seisyuu-hantatsushi/pcb/ledboard/ledboard.kicad_pcb

## KiCad design ledboard/ledboard.kicad_pcb (2026-04-18)

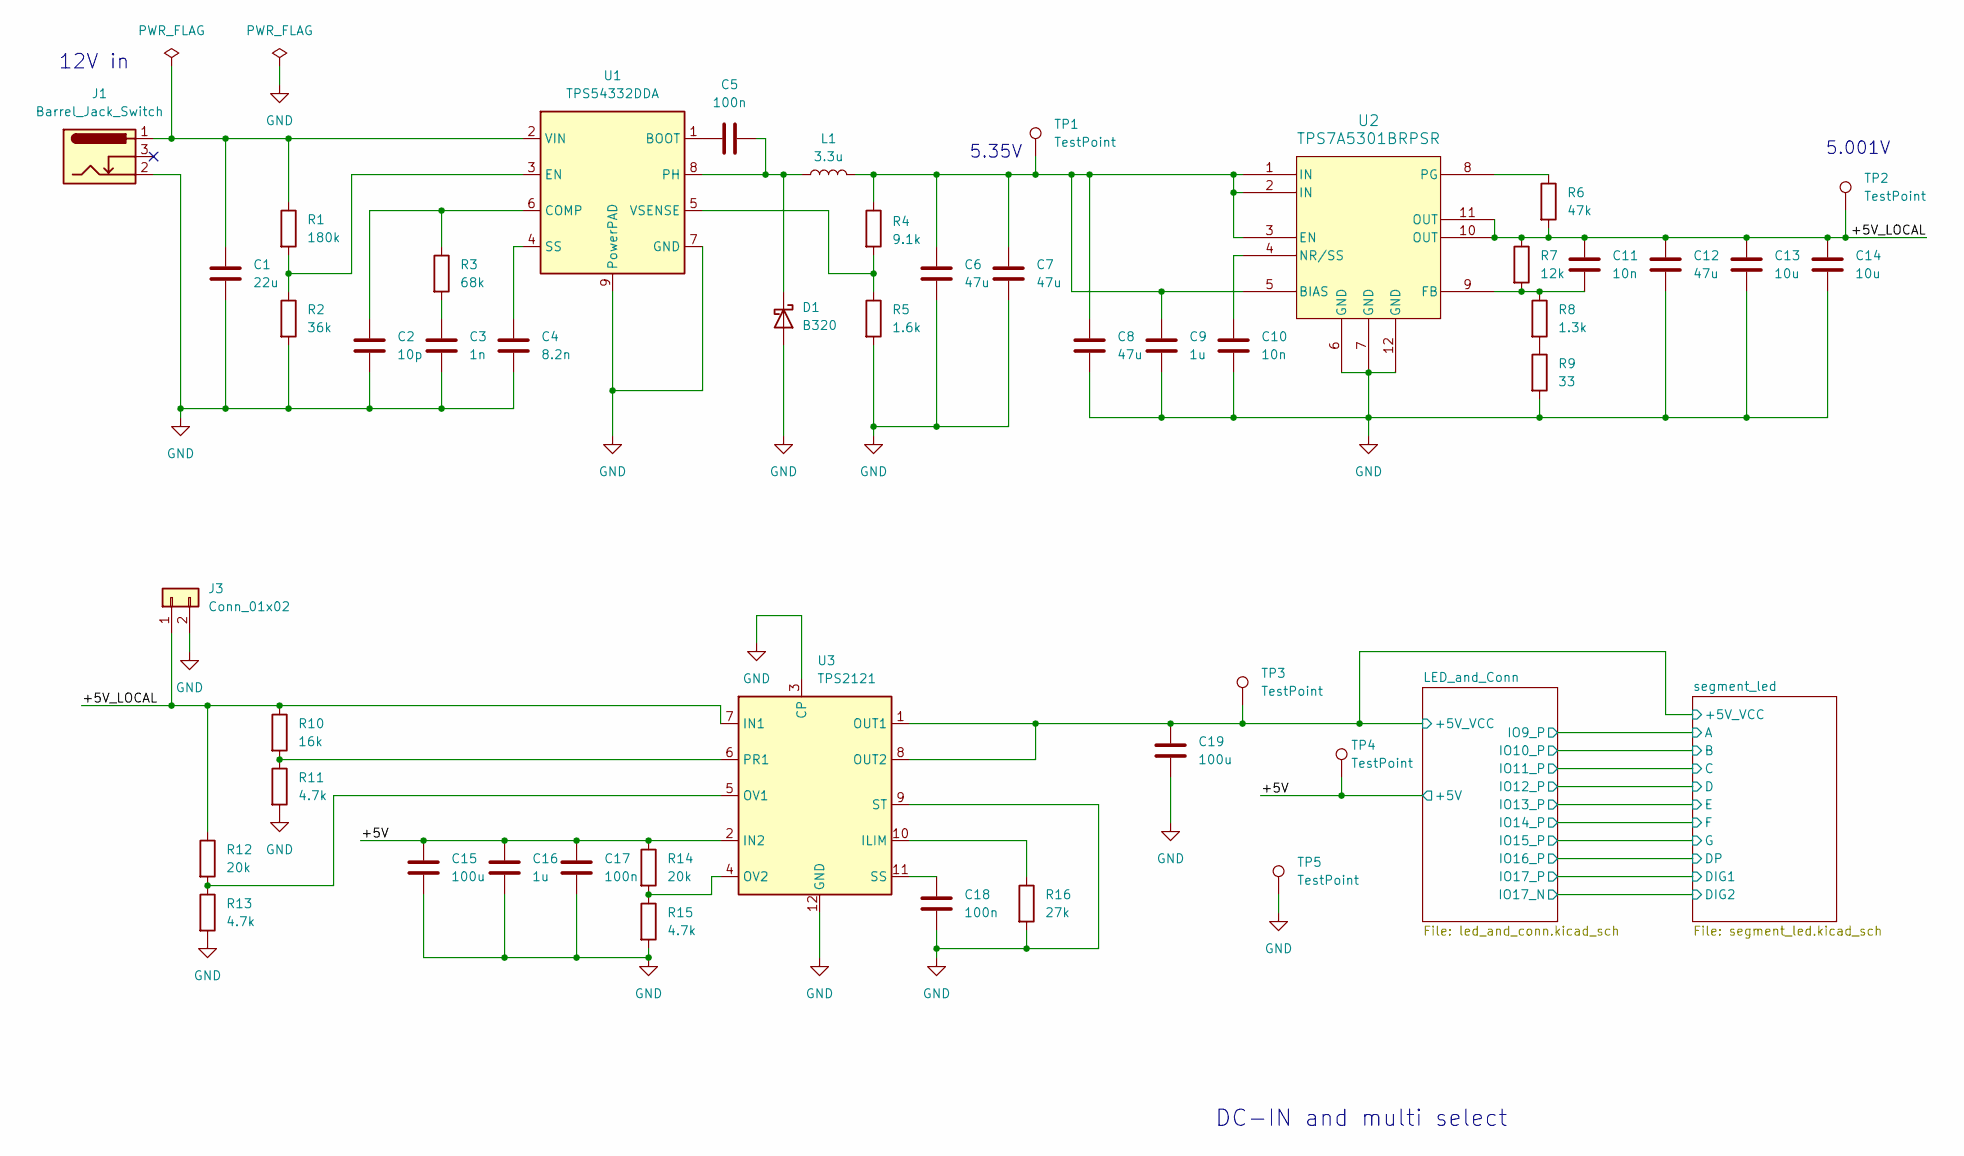
[picture p1: schematic ledboard.kicad_sch]

Parts:
C1: 22u; C_1206_3216Metric; MPN GRM31CC71E226ME15; LCSC Part # C5272872
C2: 10p; C_0402_1005Metric; MPN GRM1555C1E100JA01D; LCSC Part # C161512
C3: 1n; C_0201_0603Metric; MPN GRM033R71C102KA01; LCSC Part # C76942
C4: 8.2n; C_0201_0603Metric; MPN GRM033R61E822KA12D; LCSC Part # C710826
C5, C17, C18: 100n; C_0201_0603Metric; MPN GRM033C81E104ME14; LCSC Part # C412246
C6, C7, C8, C12: 47u; C_1206_3216Metric; MPN GRM31CR61C476ME44; LCSC Part # C385047
C9, C16: 1u; C_0402_1005Metric; MPN GRM155C81A105KA12D; LCSC Part # C162161
C10, C11: 10n; C_0402_1005Metric; MPN GRM155R71C103KA01D; LCSC Part # C85735
C13, C14: 10u; C_0603_1608Metric; MPN GRM188C81C106MA73D; LCSC Part # C182375
C15, C19: 100u; C_1210_3225Metric; MPN GRM32ER61A107ME20; LCSC Part # C84455
D1: B320; D_SMC; MPN B320-13-F; LCSC Part # C134448
J1: Barrel_Jack_Switch; MPD_EJ503A; MPN EJ503A; LCSC Part # C3095117
J3: Conn_01x02; PinHeader_1x02_P2.54mm_Vertical
L1: 3.3u; IND_BOURNS_SRN8040; MPN SRN8040-3R3Y; LCSC Part # C780188
R1: 180k; R_0603_1608Metric; MPN RC0603FR-07180KL; LCSC Part # C123419
R2: 36k; R_0603_1608Metric; MPN RC0603FR-0736KL; LCSC Part # C114619
R3: 68k; R_0603_1608Metric; MPN RC0603FR-0768KL; LCSC Part # C114633
R4: 9.1k; R_0603_1608Metric; MPN RC0603FR-0769K1L; LCSC Part # C114639
R5: 1.6k; R_0603_1608Metric; MPN RC0603FR-071K6L; LCSC Part # C165489
R6: 47k; R_0603_1608Metric; MPN RC0603FR-0747KL; LCSC Part # C105579
R7: 12k; R_0603_1608Metric; MPN RC0603FR-0712KL; LCSC Part # C114659
R8: 1.3k; R_0603_1608Metric; MPN RC0603FR-071K3L; LCSC Part # C125319
R9: 33; R_0603_1608Metric; MPN RC0603FR-0733RL; LCSC Part # C108661
R10: 16k; R_0603_1608Metric; MPN RC0603FR-0716KL; LCSC Part # C137788
R11, R13, R15: 4.7k; R_0603_1608Metric; MPN RC0603FR-074K7L; LCSC Part # C99782
R12, R14: 20k; R_0603_1608Metric; MPN RC0603FR-0720KL; LCSC Part # C105575
R16: 27k; R_0603_1608Metric; MPN RC0603FR-0727KL; LCSC Part # C114614
TP1, TP2, TP3, TP4, TP5: TestPoint; TestPoint_Keystone_5000-5004_Miniature; MPN 5002; LCSC Part # C238123
U1: TPS54332DDA; DDA8_3X2P13; MPN TPS54332DDAR; LCSC Part # C41312
U2: TPS7A5301BRPSR; VQFN-HR12_RPS_TEX; MPN TPS7A5301BRPSR; LCSC Part # C2868223
U3: TPS2121; RUX0012A; MPN TPS2121RUXR; LCSC Part # C485916

Connections:
/+5V: C15.1, C16.1, C17.1, R14.1, TP4.1, U3.2 (IN2); also elsewhere on the board
/+5V_LOCAL: C11.1, C12.1, C13.1, C14.1, J3.1, R6.2, R7.1, R10.1, R12.1, TP2.1, U2.10 (OUT), U2.11 (OUT), U3.7 (IN1)
/LED_and_Conn/+5V_VCC: C19.1, TP3.1, U3.1 (OUT1), U3.8 (OUT2); also elsewhere on the board
GND: C1.2, C2.2, C3.2, C4.2, C6.2, C7.2, C8.2, C9.2, C10.2, C12.2, C13.2, C14.2, C15.2, C16.2, C17.2, C18.2, C19.2, D1.2 (A), J1.2, J3.2, R2.2, R5.2, R9.2, R11.2, R13.2, R15.2, R16.2, TP5.1, U1.7 (GND), U1.9 (PowerPAD), U2.6 (GND), U2.7 (GND), U2.12 (GND), U3.3 (CP), U3.9 (ST), U3.12 (GND); also elsewhere on the board
unnamed: C3.1, R3.2
unnamed: C5.1, D1.1 (K), L1.1, U1.8 (PH)
unnamed: R8.2, R9.1
unnamed: C5.2, U1.1 (BOOT)
unnamed: C2.1, R3.1, U1.6 (COMP)
unnamed: R1.2, R2.1, U1.3 (EN)
unnamed: C4.1, U1.4 (SS)
unnamed: C1.1, J1.1, R1.1, U1.2 (VIN)
unnamed: R4.2, R5.1, U1.5 (VSENSE)
unnamed: C6.1, C7.1, C8.1, C9.1, L1.2, R4.1, TP1.1, U2.1 (IN), U2.2 (IN), U2.3 (EN), U2.5 (BIAS)
unnamed: C11.2, R7.2, R8.1, U2.9 (FB)
unnamed: C10.1, U2.4 (NR/SS)
unnamed: R6.1, U2.8 (PG)
unnamed: R16.1, U3.10 (ILIM)
unnamed: R12.2, R13.1, U3.5 (OV1)
unnamed: R14.2, R15.1, U3.4 (OV2)
unnamed: R10.2, R11.1, U3.6 (PR1)
unnamed: C18.1, U3.11 (SS)

Notes on the sheet:
12V in
DC-IN and multi select
5.001V
5.35V

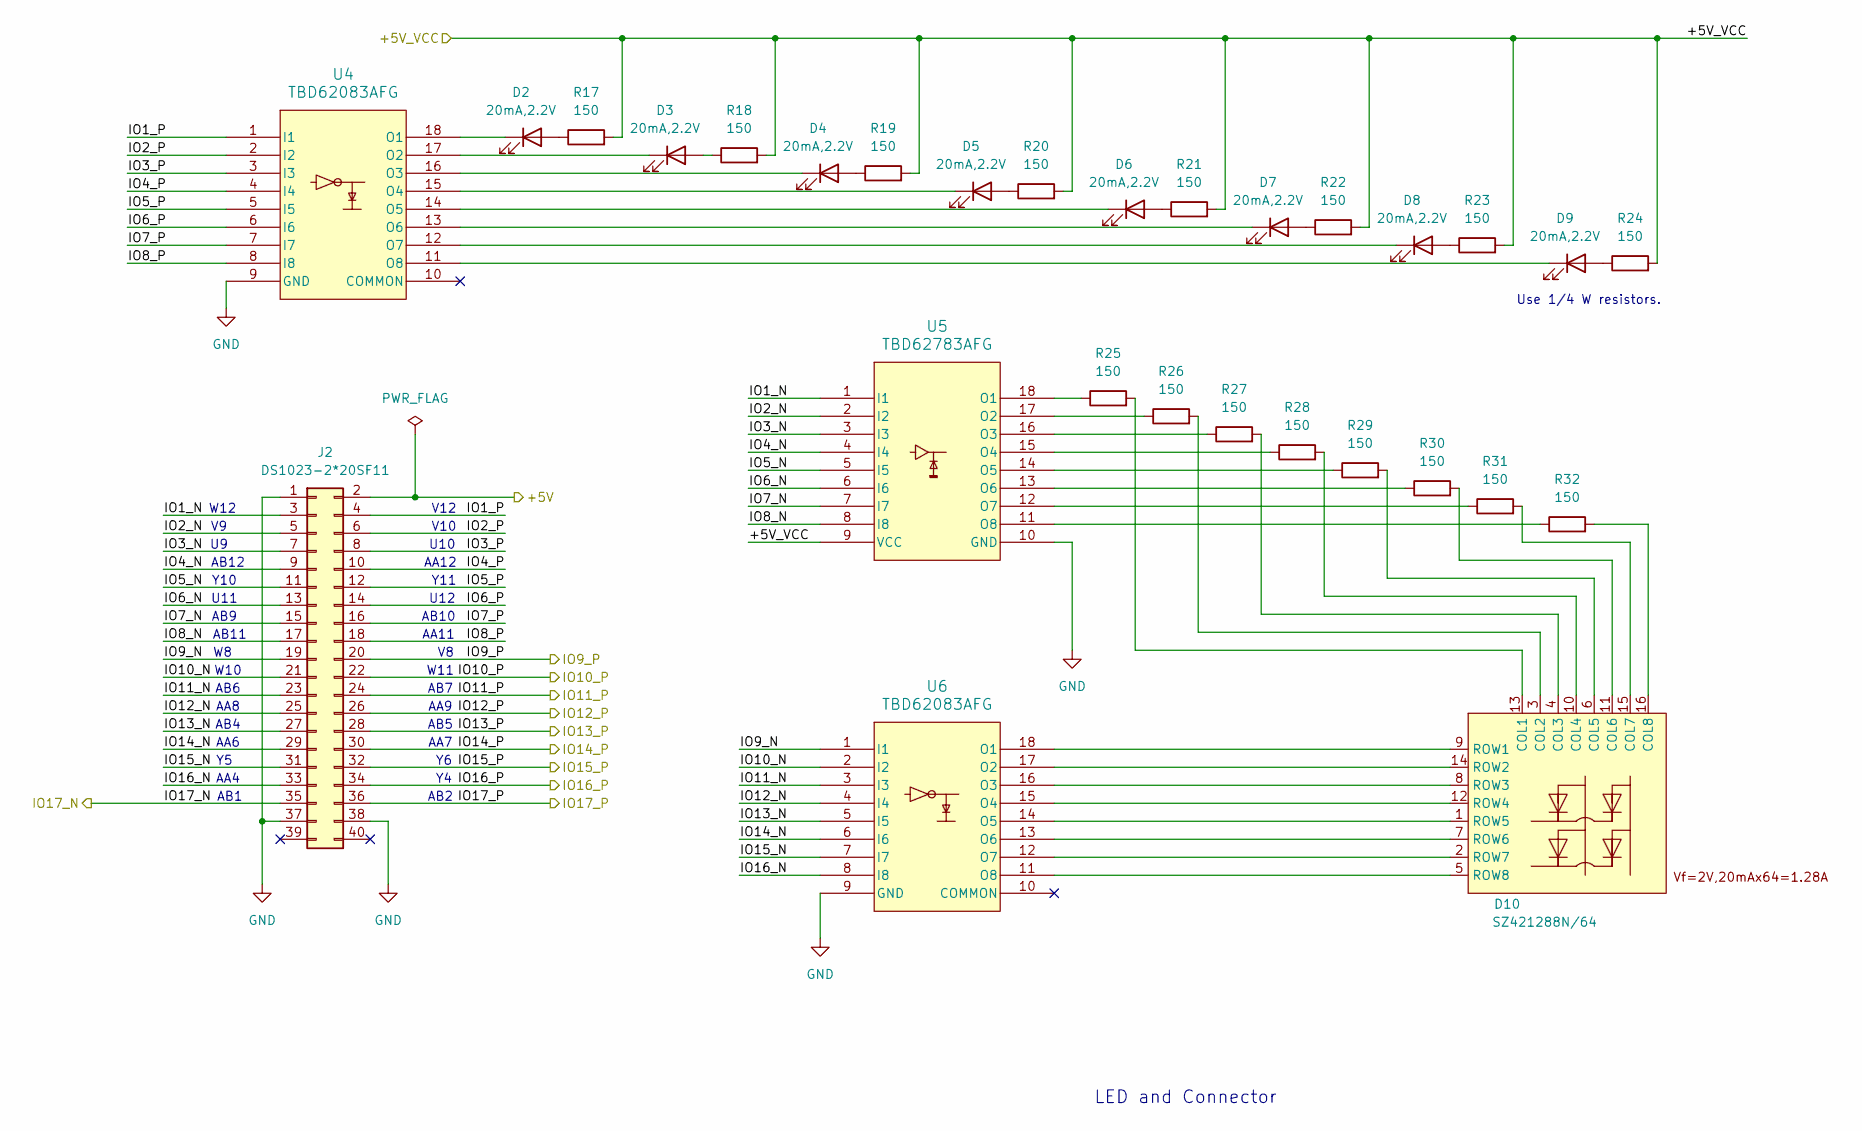
[picture p2: schematic led_and_conn.kicad_sch]

Parts:
D2, D3, D4, D5, D6, D7, D8, D9: 20mA,2.2V; LED_0603_1608Metric; MPN SML-D12V8WT86C; LCSC Part # C458032
D10: SZ421288N/64; SZ421288N_64; MPN SZ421288N/64; LCSC Part # C2980922
J2: DS1023-2*20SF11; PinSocket_2x20_P2.54mm_Vertical; MPN DS1023-2*20SF11; LCSC Part # C132132
R17, R18, R19, R20, R21, R22, R23, R24, R25, R26, R27, R28, R29, R30, R31, R32: 150; R_0603_1608Metric; MPN SR0603FR-7T150RL; LCSC Part # C873675
U4, U6: TBD62083AFG; SOP18-P-375-1p27_TOS; MPN TBD62083AFG; LCSC Part # C163228
U5: TBD62783AFG; SOP18-P-375-1p27_TOS; MPN TBD62783AFG; LCSC Part # C97745

Connections:
/+5V: J2.2; also elsewhere on the board
/LED_and_Conn/+5V_VCC: R17.2, R18.2, R19.2, R20.2, R21.2, R22.2, R23.2, R24.2, U5.9 (VCC); also elsewhere on the board
/LED_and_Conn/IO1_N: J2.3, U5.1 (I1)
/LED_and_Conn/IO1_P: J2.4, U4.1 (I1)
/LED_and_Conn/IO2_N: J2.5, U5.2 (I2)
/LED_and_Conn/IO2_P: J2.6, U4.2 (I2)
/LED_and_Conn/IO3_N: J2.7, U5.3 (I3)
/LED_and_Conn/IO3_P: J2.8, U4.3 (I3)
/LED_and_Conn/IO4_N: J2.9, U5.4 (I4)
/LED_and_Conn/IO4_P: J2.10, U4.4 (I4)
/LED_and_Conn/IO5_N: J2.11, U5.5 (I5)
/LED_and_Conn/IO5_P: J2.12, U4.5 (I5)
/LED_and_Conn/IO6_N: J2.13, U5.6 (I6)
/LED_and_Conn/IO6_P: J2.14, U4.6 (I6)
/LED_and_Conn/IO7_N: J2.15, U5.7 (I7)
/LED_and_Conn/IO7_P: J2.16, U4.7 (I7)
/LED_and_Conn/IO8_N: J2.17, U5.8 (I8)
/LED_and_Conn/IO8_P: J2.18, U4.8 (I8)
/LED_and_Conn/IO9_N: J2.19, U6.1 (I1)
/LED_and_Conn/IO9_P: J2.20; also elsewhere on the board
/LED_and_Conn/IO10_N: J2.21, U6.2 (I2)
/LED_and_Conn/IO10_P: J2.22; also elsewhere on the board
/LED_and_Conn/IO11_N: J2.23, U6.3 (I3)
/LED_and_Conn/IO11_P: J2.24; also elsewhere on the board
/LED_and_Conn/IO12_N: J2.25, U6.4 (I4)
/LED_and_Conn/IO12_P: J2.26; also elsewhere on the board
/LED_and_Conn/IO13_N: J2.27, U6.5 (I5)
/LED_and_Conn/IO13_P: J2.28; also elsewhere on the board
/LED_and_Conn/IO14_N: J2.29, U6.6 (I6)
/LED_and_Conn/IO14_P: J2.30; also elsewhere on the board
/LED_and_Conn/IO15_N: J2.31, U6.7 (I7)
/LED_and_Conn/IO15_P: J2.32; also elsewhere on the board
/LED_and_Conn/IO16_N: J2.33, U6.8 (I8)
/LED_and_Conn/IO16_P: J2.34; also elsewhere on the board
/LED_and_Conn/IO17_N: J2.35; also elsewhere on the board
/LED_and_Conn/IO17_P: J2.36; also elsewhere on the board
GND: J2.1, J2.37, J2.38, U4.9 (GND), U5.10 (GND), U6.9 (GND); also elsewhere on the board
unnamed: D2.2 (A), R17.1
unnamed: D2.1 (K), U4.18 (O1)
unnamed: D3.2 (A), R18.1
unnamed: D3.1 (K), U4.17 (O2)
unnamed: D4.2 (A), R19.1
unnamed: D4.1 (K), U4.16 (O3)
unnamed: D5.2 (A), R20.1
unnamed: D5.1 (K), U4.15 (O4)
unnamed: D6.2 (A), R21.1
unnamed: D6.1 (K), U4.14 (O5)
unnamed: D7.2 (A), R22.1
unnamed: D7.1 (K), U4.13 (O6)
unnamed: D8.2 (A), R23.1
unnamed: D8.1 (K), U4.12 (O7)
unnamed: D9.2 (A), R24.1
unnamed: D9.1 (K), U4.11 (O8)
unnamed: D10.13 (COL1), R25.2
unnamed: D10.3 (COL2), R26.2
unnamed: D10.4 (COL3), R27.2
unnamed: D10.10 (COL4), R28.2
unnamed: D10.6 (COL5), R29.2
unnamed: D10.11 (COL6), R30.2
unnamed: D10.15 (COL7), R31.2
unnamed: D10.16 (COL8), R32.2
unnamed: D10.9 (ROW1), U6.18 (O1)
unnamed: D10.14 (ROW2), U6.17 (O2)
unnamed: D10.8 (ROW3), U6.16 (O3)
unnamed: D10.12 (ROW4), U6.15 (O4)
unnamed: D10.1 (ROW5), U6.14 (O5)
unnamed: D10.7 (ROW6), U6.13 (O6)
unnamed: D10.2 (ROW7), U6.12 (O7)
unnamed: D10.5 (ROW8), U6.11 (O8)
unnamed: R25.1, U5.18 (O1)
unnamed: R26.1, U5.17 (O2)
unnamed: R27.1, U5.16 (O3)
unnamed: R28.1, U5.15 (O4)
unnamed: R29.1, U5.14 (O5)
unnamed: R30.1, U5.13 (O6)
unnamed: R31.1, U5.12 (O7)
unnamed: R32.1, U5.11 (O8)

Notes on the sheet:
U12
AA12
W11
U10
AB4
AB1
AA8
AB2
AB5
Y11
AA4
Y10
AB10
AA9
V10
AB6
W12
LED and Connector
AB7
Use 1/4 W resistors.
AB9
AA6
V12
U11
AA7
AB11
AA11
AB12
W10

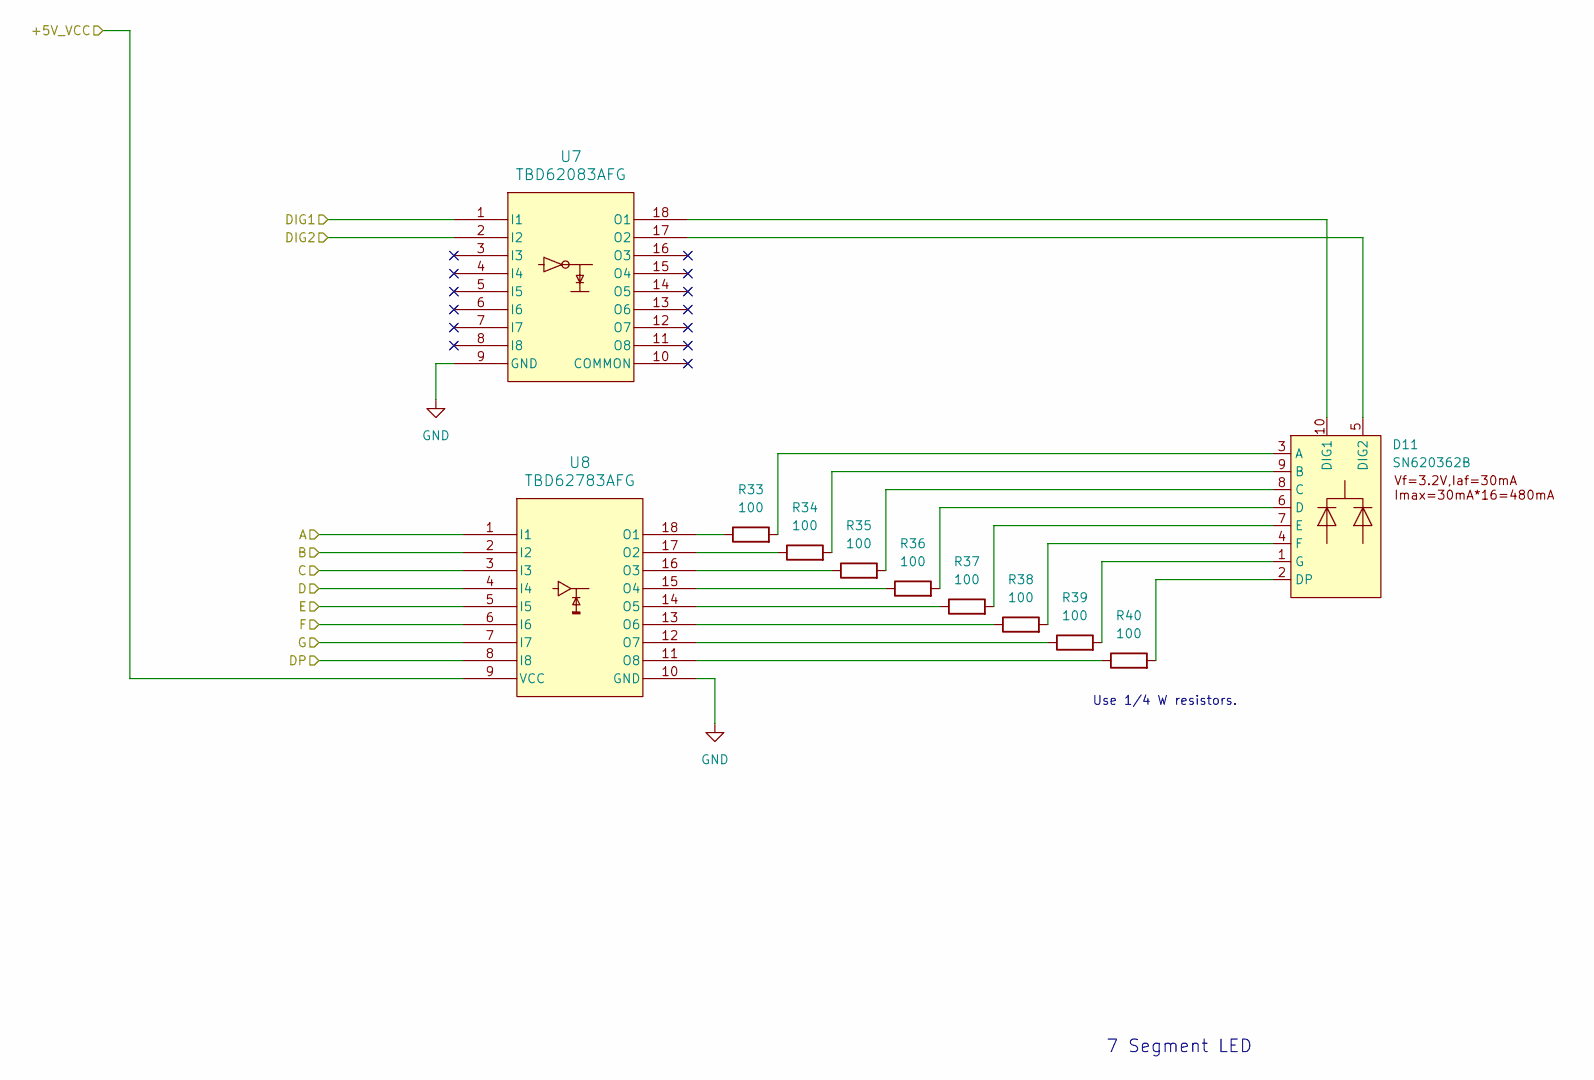
[picture p3: schematic segment_led.kicad_sch]

Parts:
D11: SN620362B; MPN SN620362B; LCSC Part # C96556
R33, R34, R35, R36, R37, R38, R39, R40: 100; R_0603_1608Metric; MPN SR0603FR-7T100RL; LCSC Part # C873671
U7: TBD62083AFG; SOP18-P-375-1p27_TOS; MPN TBD62083AFG; LCSC Part # C163228
U8: TBD62783AFG; SOP18-P-375-1p27_TOS; MPN TBD62783AFG; LCSC Part # C97745

Connections:
/LED_and_Conn/+5V_VCC: U8.9 (VCC); also elsewhere on the board
/LED_and_Conn/IO9_P: U8.1 (I1); also elsewhere on the board
/LED_and_Conn/IO10_P: U8.2 (I2); also elsewhere on the board
/LED_and_Conn/IO11_P: U8.3 (I3); also elsewhere on the board
/LED_and_Conn/IO12_P: U8.4 (I4); also elsewhere on the board
/LED_and_Conn/IO13_P: U8.5 (I5); also elsewhere on the board
/LED_and_Conn/IO14_P: U8.6 (I6); also elsewhere on the board
/LED_and_Conn/IO15_P: U8.7 (I7); also elsewhere on the board
/LED_and_Conn/IO16_P: U8.8 (I8); also elsewhere on the board
/LED_and_Conn/IO17_N: U7.2 (I2); also elsewhere on the board
/LED_and_Conn/IO17_P: U7.1 (I1); also elsewhere on the board
GND: U7.9 (GND), U8.10 (GND); also elsewhere on the board
unnamed: D11.3 (A), R33.2
unnamed: D11.9 (B), R34.2
unnamed: D11.8 (C), R35.2
unnamed: D11.6 (D), R36.2
unnamed: D11.10 (DIG1), U7.18 (O1)
unnamed: D11.5 (DIG2), U7.17 (O2)
unnamed: D11.2 (DP), R40.2
unnamed: D11.7 (E), R37.2
unnamed: D11.4 (F), R38.2
unnamed: D11.1 (G), R39.2
unnamed: R33.1, U8.18 (O1)
unnamed: R34.1, U8.17 (O2)
unnamed: R35.1, U8.16 (O3)
unnamed: R36.1, U8.15 (O4)
unnamed: R37.1, U8.14 (O5)
unnamed: R38.1, U8.13 (O6)
unnamed: R39.1, U8.12 (O7)
unnamed: R40.1, U8.11 (O8)

Notes on the sheet:
7 Segment LED
Use 1/4 W resistors.

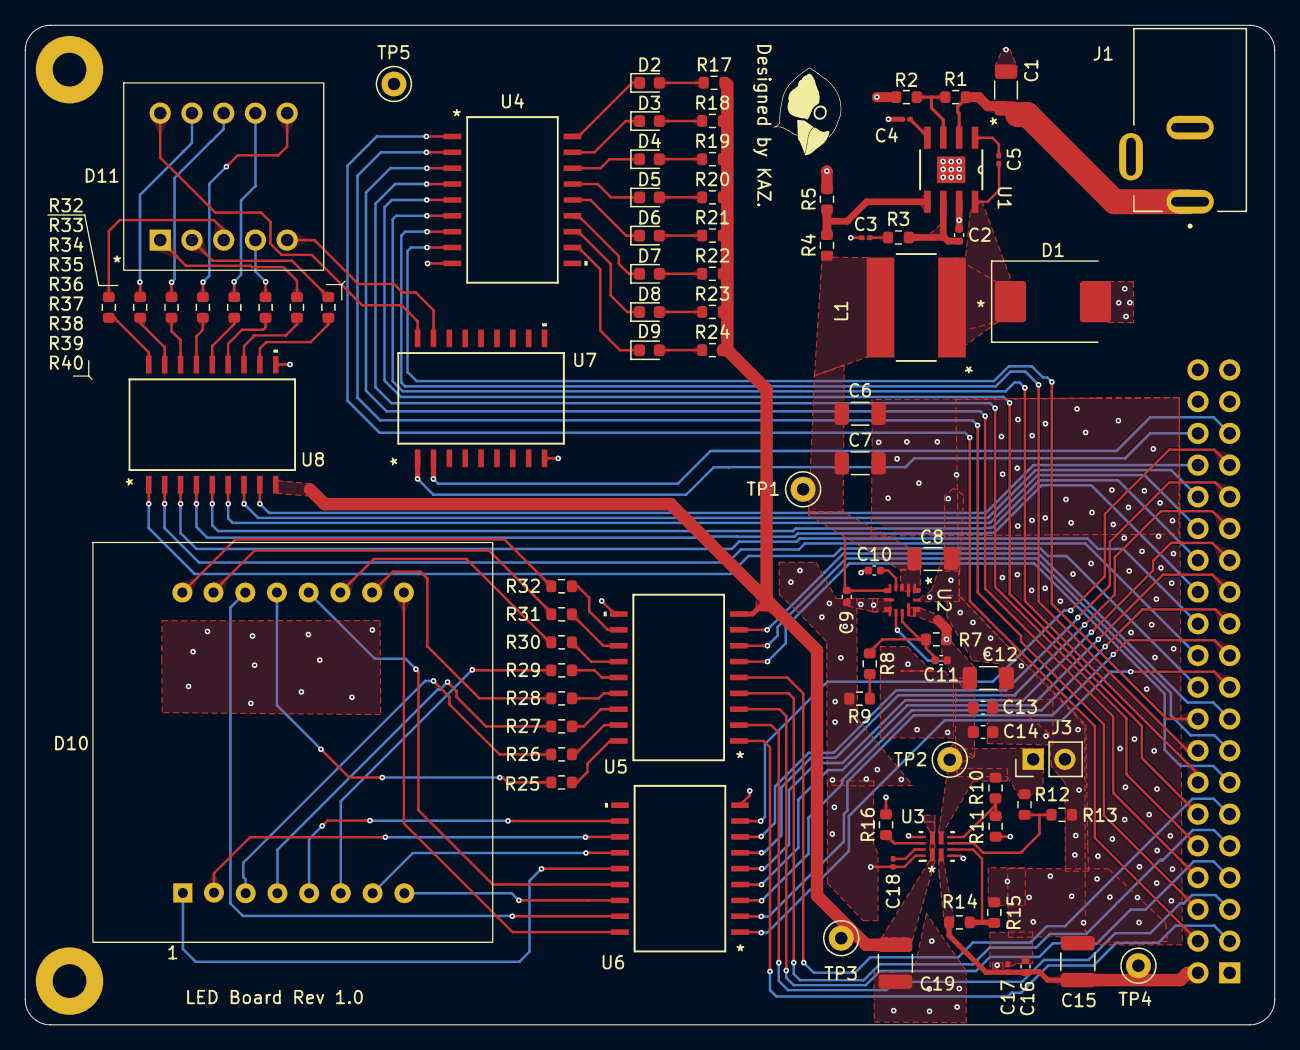
[picture p4: board ledboard.kicad_pcb from above]

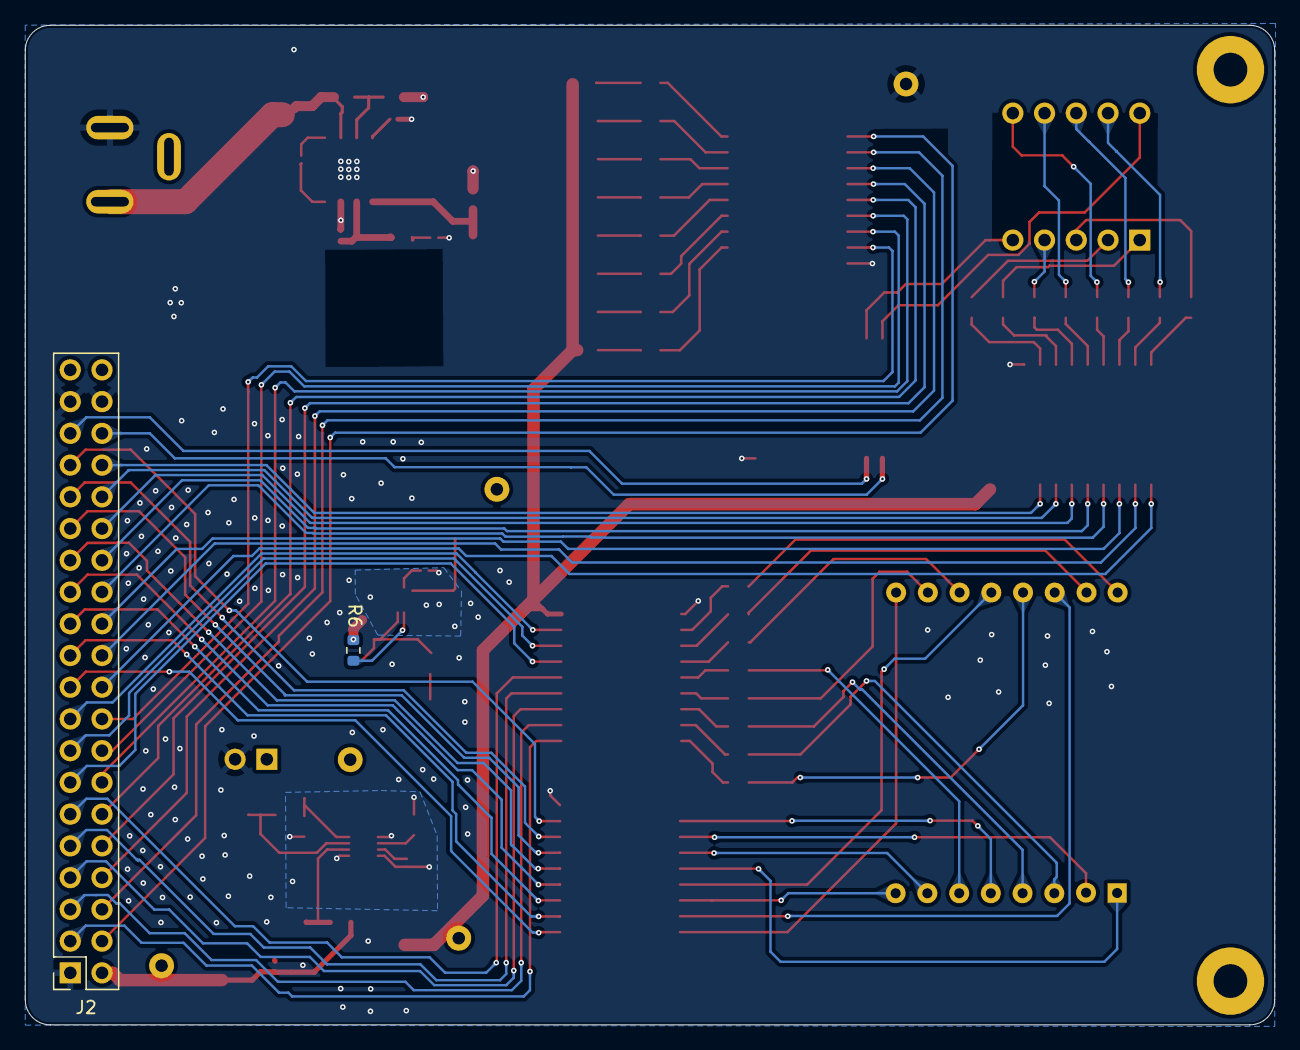
[picture p5: board ledboard.kicad_pcb from below]

Board: 2 copper layers, 100.0 x 80.0 mm, 87 parts (2 on the bottom side), 114 nets.
