seisyuu-hantatsushi/pcb/(commit log)

2026-03-28 Temporary schematic fix.
    [led_and_conn.kicad_sch, ledboard.kicad_sch, segment_led.kicad_sch]
2026-03-29 各種定数見直し,TPS2121の前後にデカップリングコンデンサを配置.
    [led_and_conn.kicad_sch, ledboard.kicad_sch, segment_led.kicad_sch]
2026-03-29 部品の再アノテーションを行う.
    [led_and_conn.kicad_sch, ledboard.kicad_sch, segment_led.kicad_sch]
2026-04-04 部品が決まったので,コミットします.
    [led_and_conn.kicad_sch, ledboard.kicad_sch, segment_led.kicad_sch]
2026-04-04 ERC解消まで.
    [led_and_conn.kicad_sch, ledboard.kicad_sch, segment_led.kicad_sch]
2026-04-05 PCB1レイアウトを開始.
    [ledboard.kicad_pcb]
2026-04-12 PCBデザイン. 未結線がなくなったところまで.
    [ledboard.kicad_pcb]
2026-04-12 アートワーク完了.
    [ledboard.kicad_pcb, ledboard.kicad_sch]
2026-04-13 log用のフットプリント追加.
2026-04-13 LOGとボード名を追加します.
    [led_and_conn.kicad_sch, ledboard.kicad_pcb]
2026-04-14 部品変更とアートワークの修正.
    [led_and_conn.kicad_sch, ledboard.kicad_pcb, ledboard.kicad_sch]
2026-04-16 LSCS品番を追加. コンデンサの品番を変更します.
    [led_and_conn.kicad_sch, ledboard.kicad_pcb, ledboard.kicad_sch, segment_led.kicad_sch]
2026-04-18 L1をBOURNS SR8040-3R3Yに変更しました.
    [ledboard.kicad_pcb, ledboard.kicad_sch]
